SaurabhSinha-2006/MachXO4-Canvas/Doc/machx04_devboard.png

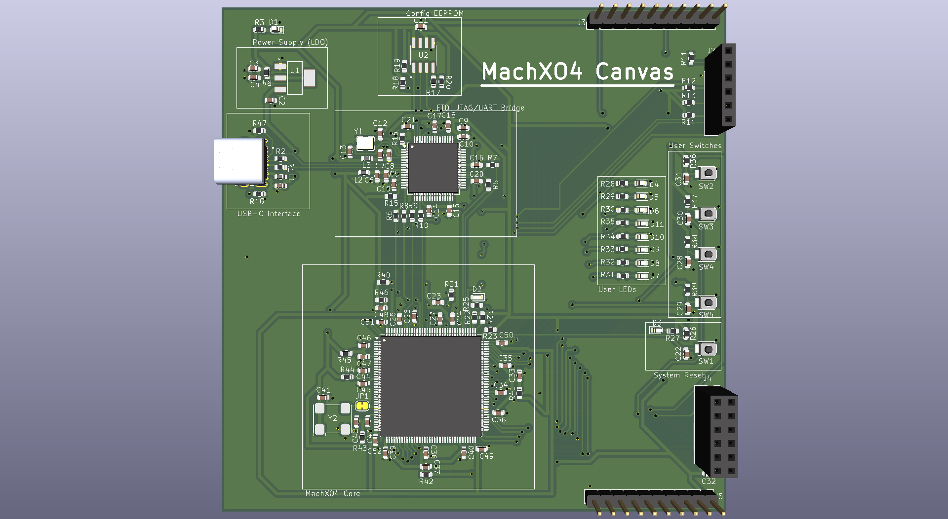
Doc/machx04_devboard.png
