SaurabhSinha-2006/MachXO4-Canvas/Hardware/Custom Library/93LC56C-I_SN/93LC56C-I_SN.step

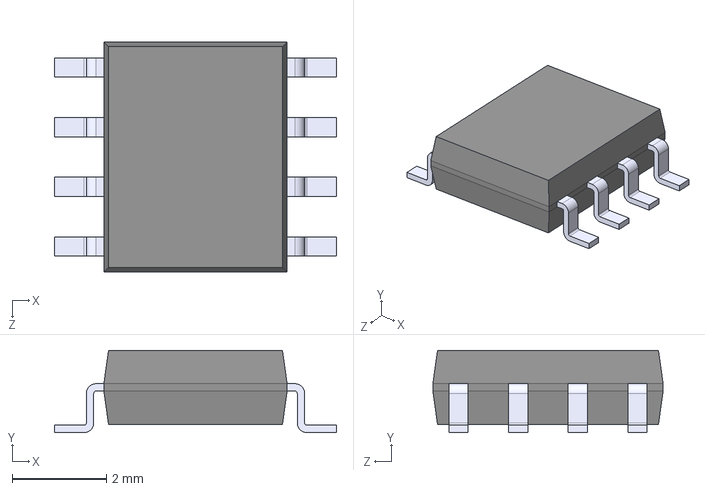
[picture p3: CAD file, 2026-10-26]
Hardware/Custom Library/93LC56C-I_SN/93LC56C-I_SN.step
6.00 x 1.75 x 4.90 mm
