SaurabhSinha-2006/MachXO4-Canvas/Hardware/Custom Library/FT2232HL-REEL/FT2232HL-REEL.step

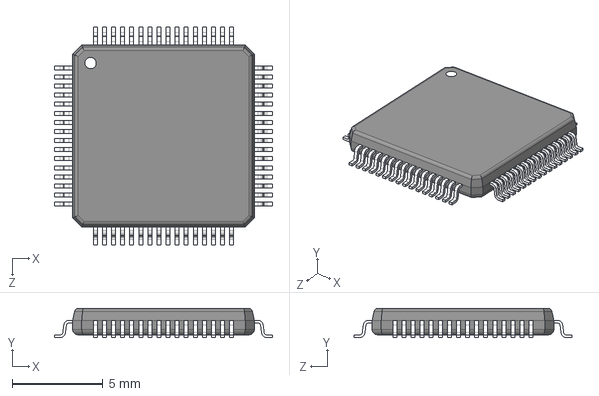
[picture p4: CAD file, 2026-10-26]
Hardware/Custom Library/FT2232HL-REEL/FT2232HL-REEL.step
12.0 x 1.60 x 12.0 mm
