SaurabhSinha-2006/MachXO4-Canvas/Hardware/Custom Library/NCP1117ST33T3G/NCP1117ST33T3G.step

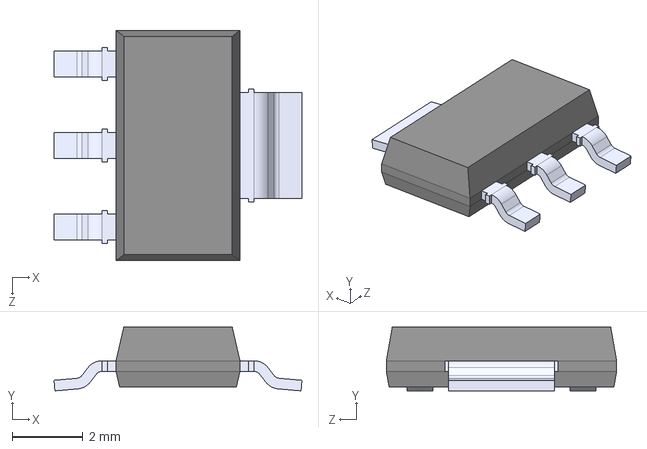
[picture p5: CAD file, 2026-10-26]
Hardware/Custom Library/NCP1117ST33T3G/NCP1117ST33T3G.step
7.00 x 1.80 x 6.50 mm
