SaurabhSinha-2006/MachXO4-Canvas/Hardware/Custom Library/USB4085-GF-A_REVA4/USB4085-GF-A_REVA4.step

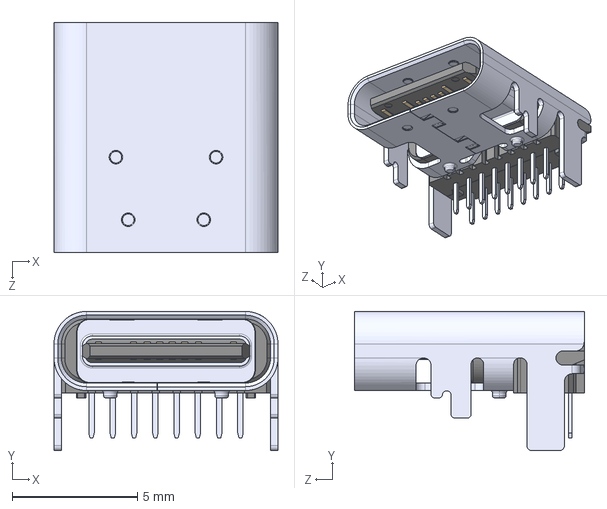
[picture p6: CAD file, 2026-10-26]
Hardware/Custom Library/USB4085-GF-A_REVA4/USB4085-GF-A_REVA4.step
8.95 x 5.56 x 9.17 mm
