SaurabhSinha-2006/MachXO4-Canvas/Hardware/Custom Library/61400416021/61400416021.step

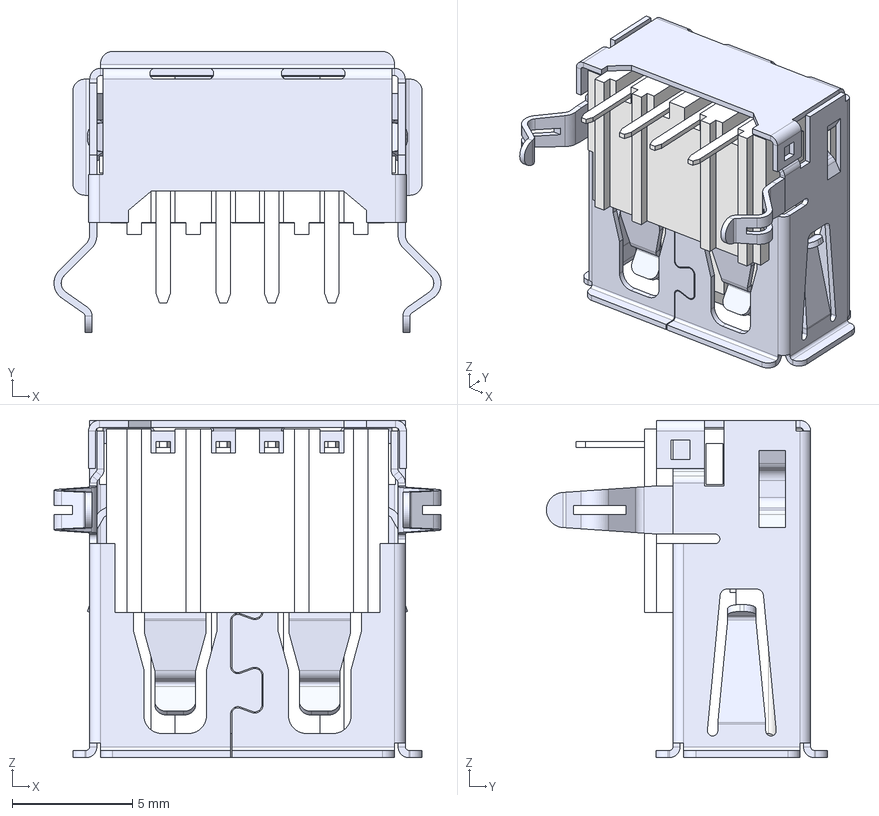
[picture p7: CAD file, 2026-10-26]
Hardware/Custom Library/61400416021/61400416021.step
16.1 x 11.7 x 14.0 mm
