SaurabhSinha-2006/MachXO4-Canvas/Doc/machx04_devboard.pdf

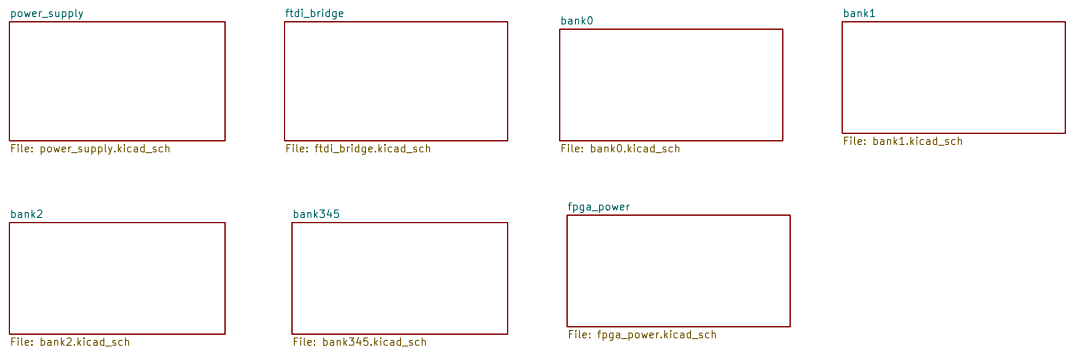
[picture p8: page 1]

Designed by: Saurabh Sinha
IIIT NR
Sheet: /
File: machx04_devboard.kicad_sch
Title: Master sheet

Size: A4 | Rev: v1.0
KiCad E.D.A. 10.0.5 | Id: 1/8

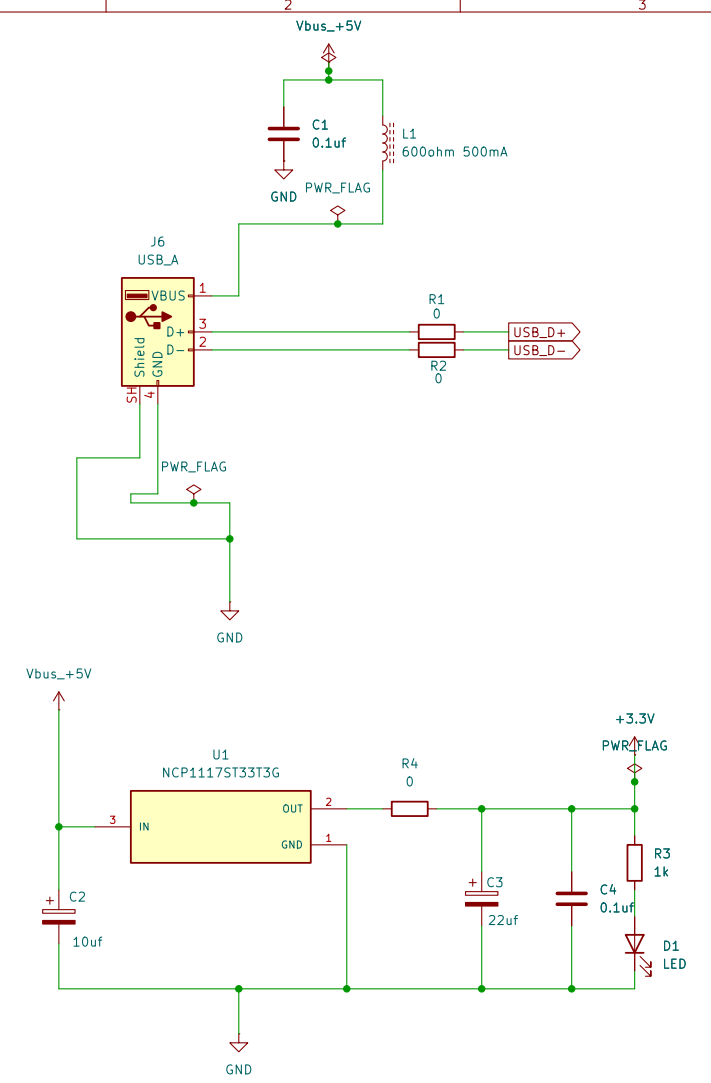
[picture p9: page 2]

Designed by: Saurabh Sinha
IIIT NR
Sheet: /power_supply/
File: power_supply.kicad_sch
Title: 3.3V Power Architecture

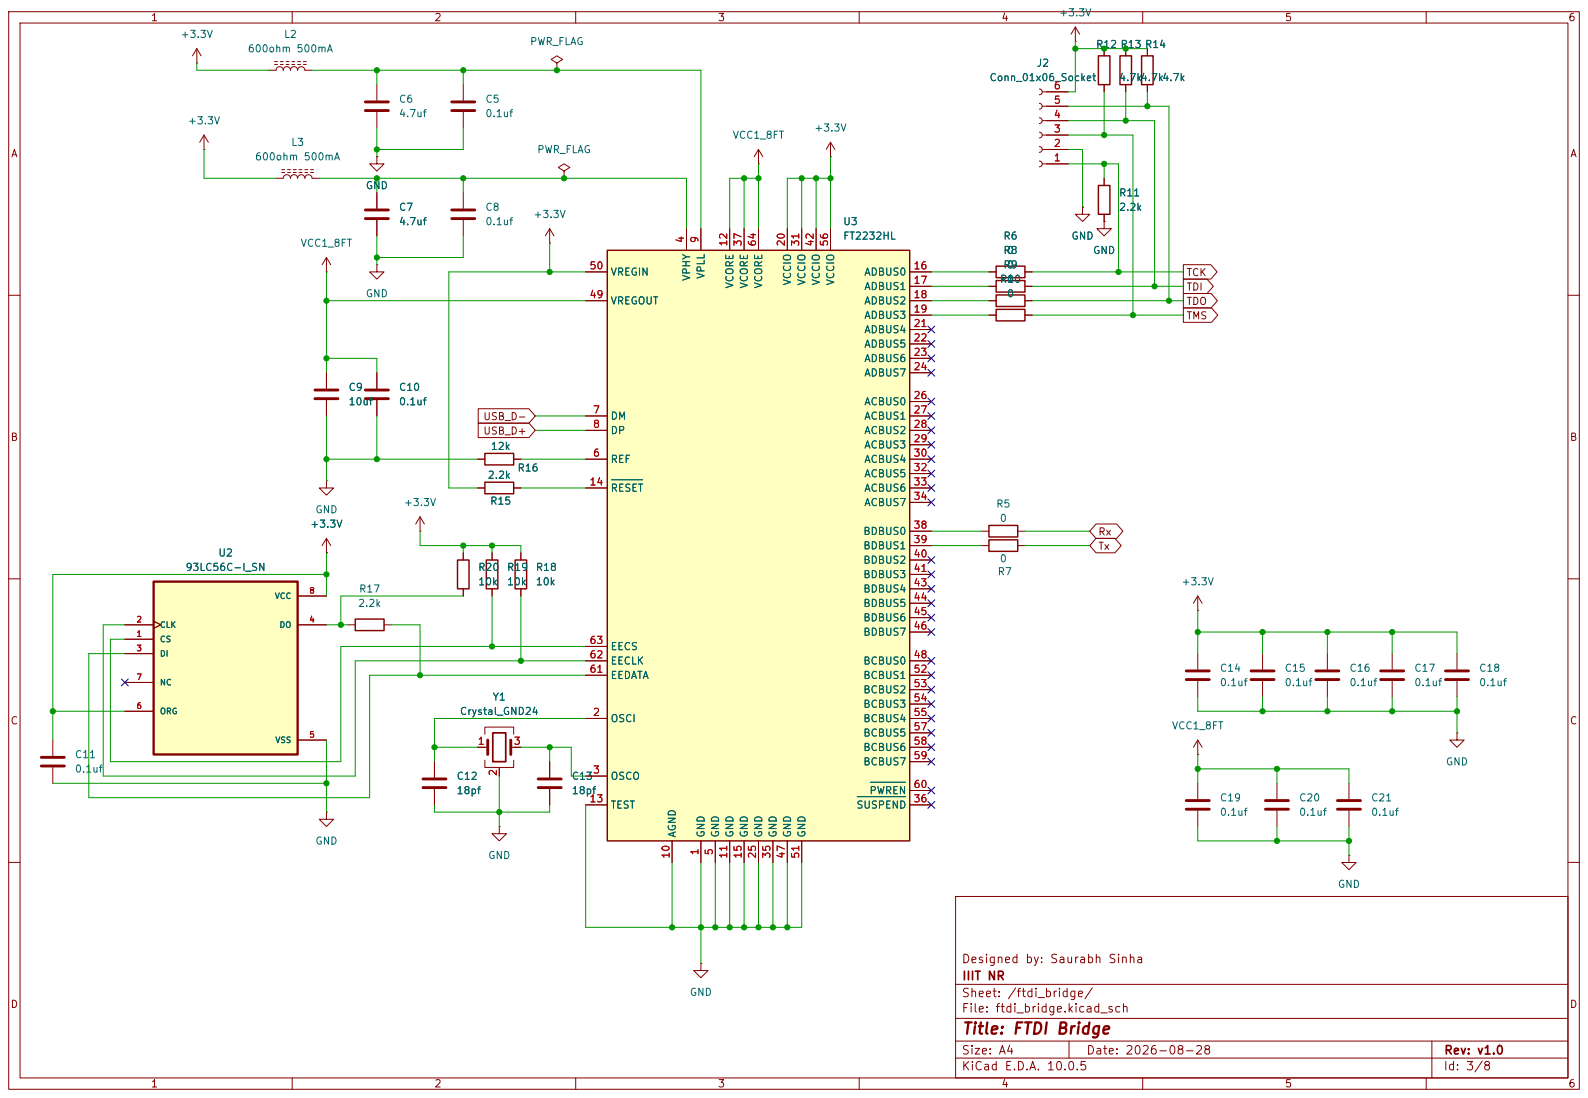
[picture p10: page 3]

5 REF 6 DM 7 DP 8 VPLL 9 AGND 10 GND 11 VCORE 12

1 OSCI 2 OSCO 3 VPHY 4 GND

Designed by: Saurabh Sinha
IIIT NR
Sheet: /ftdi_bridge/
File: ftdi_bridge.kicad_sch
Title: FTDI Bridge

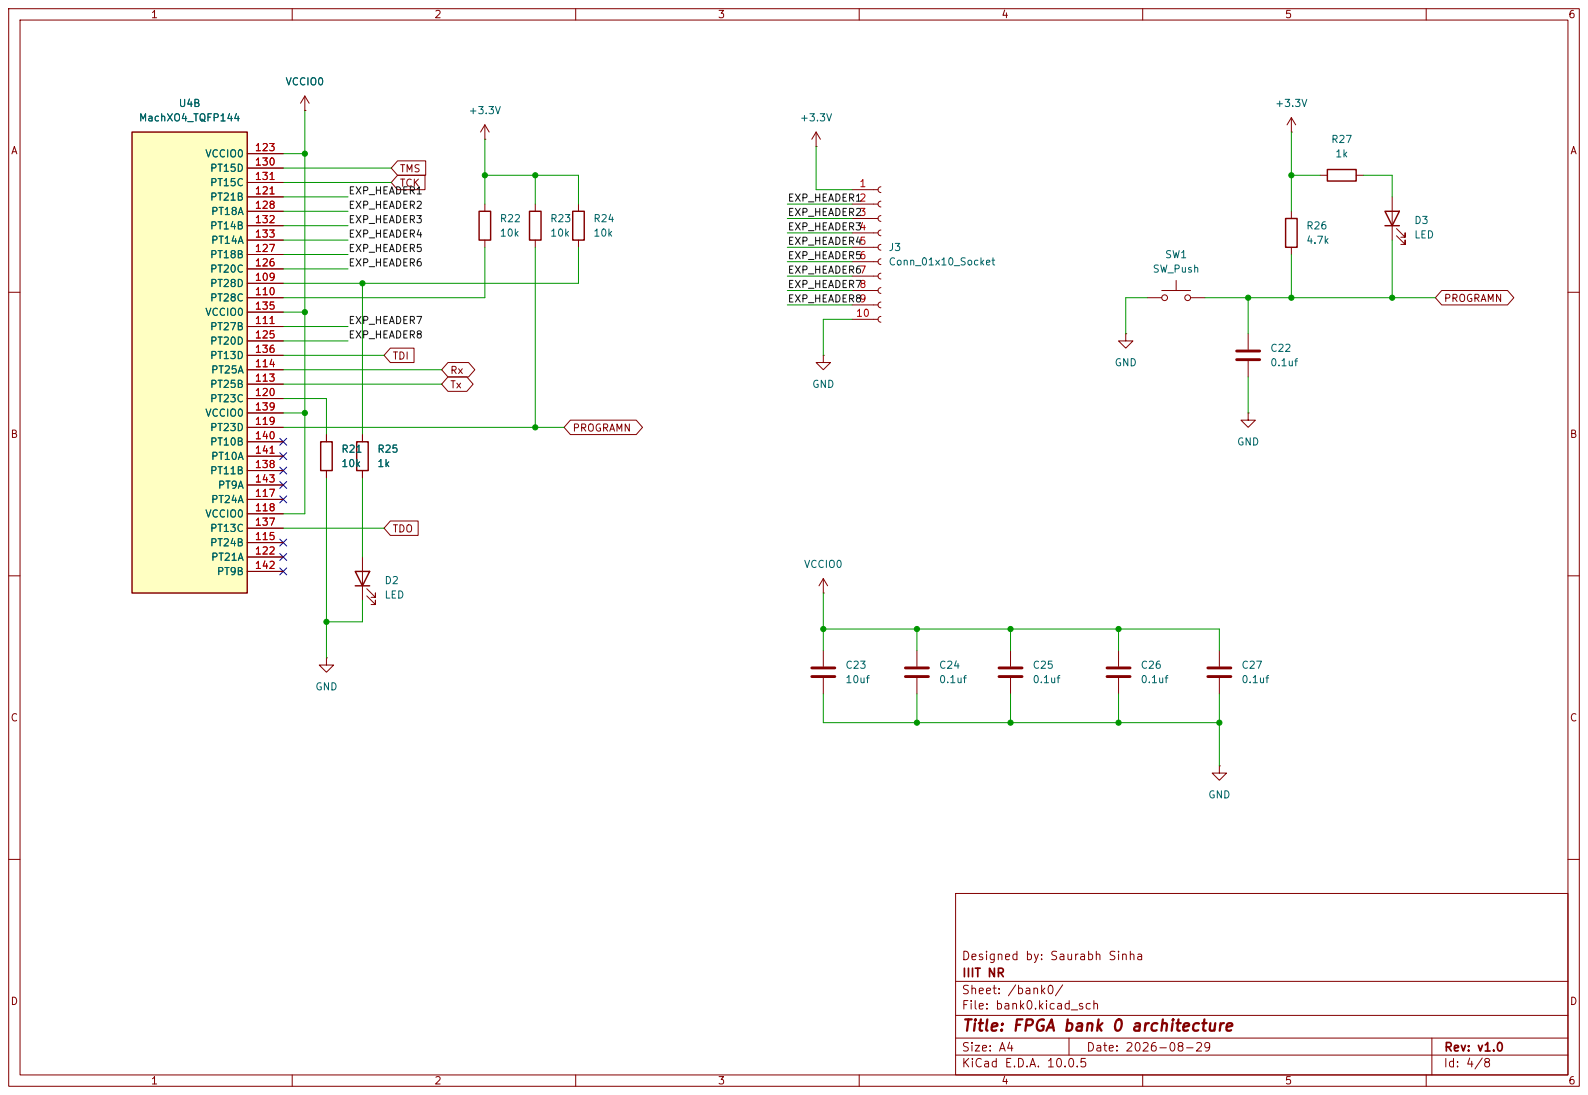
[picture p11: page 4]

Designed by: Saurabh Sinha
IIIT NR
Sheet: /bank0/
File: bank0.kicad_sch
Title: FPGA bank 0 architecture

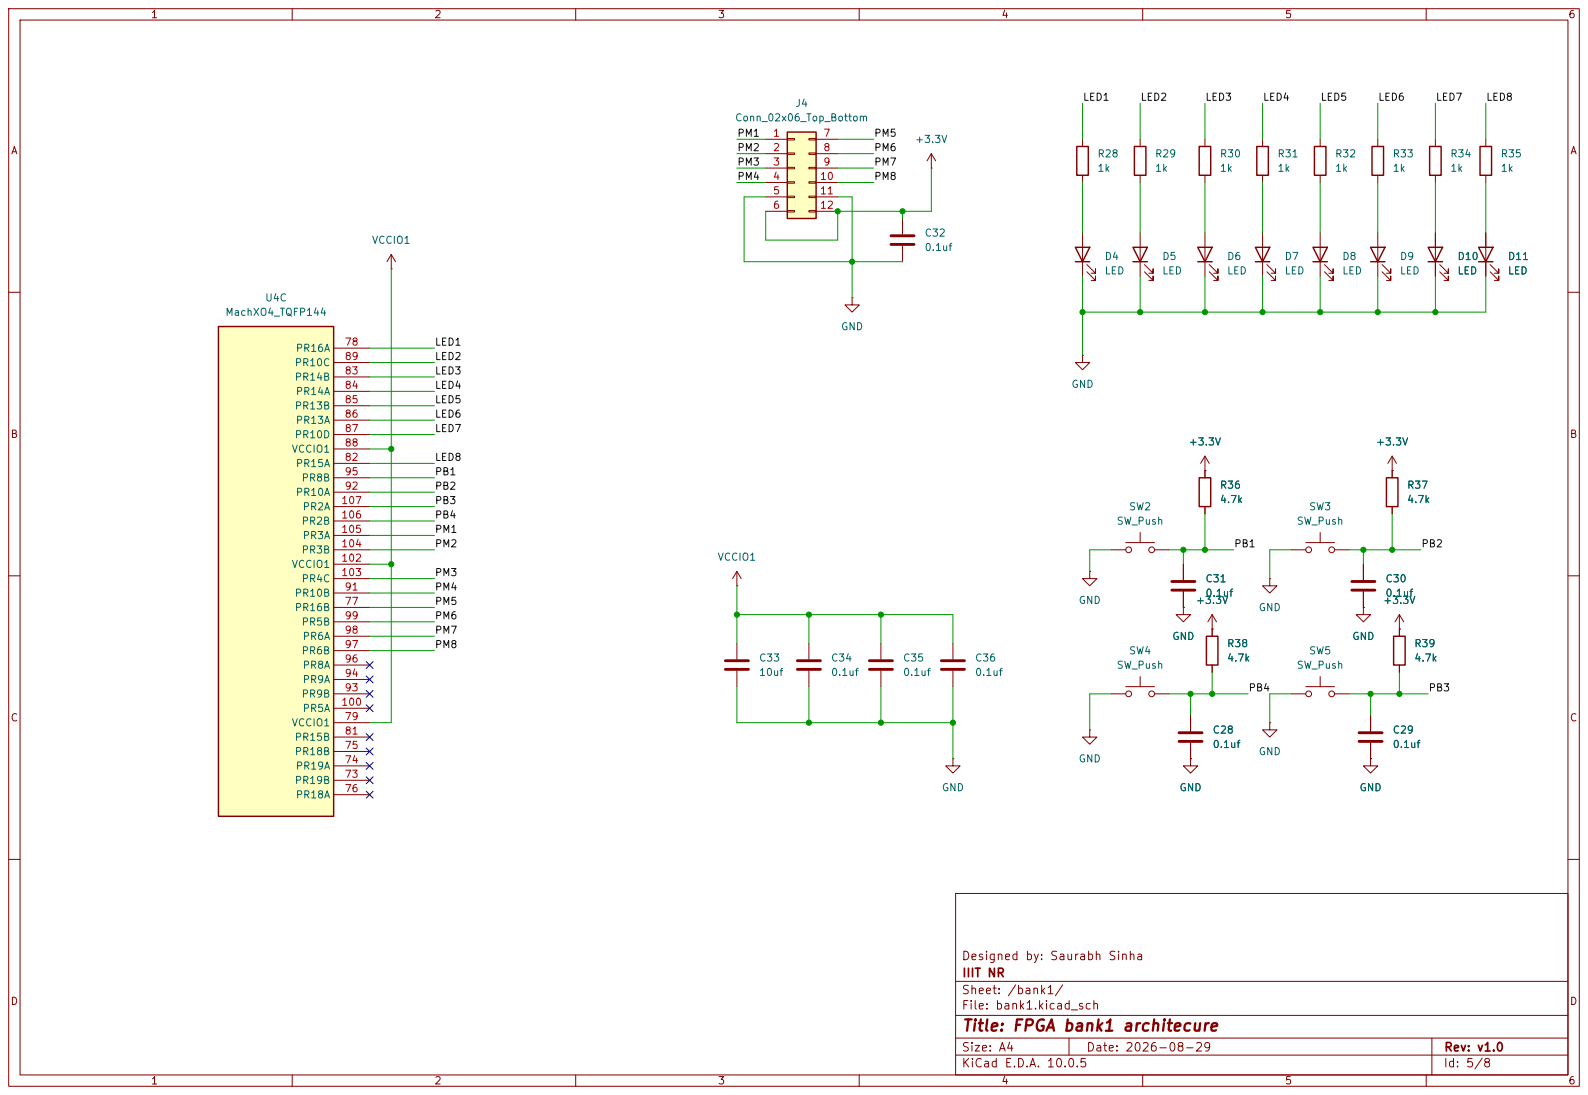
[picture p12: page 5]

Designed by: Saurabh Sinha
IIIT NR
Sheet: /bank1/
File: bank1.kicad_sch
Title: FPGA bank1 architecure

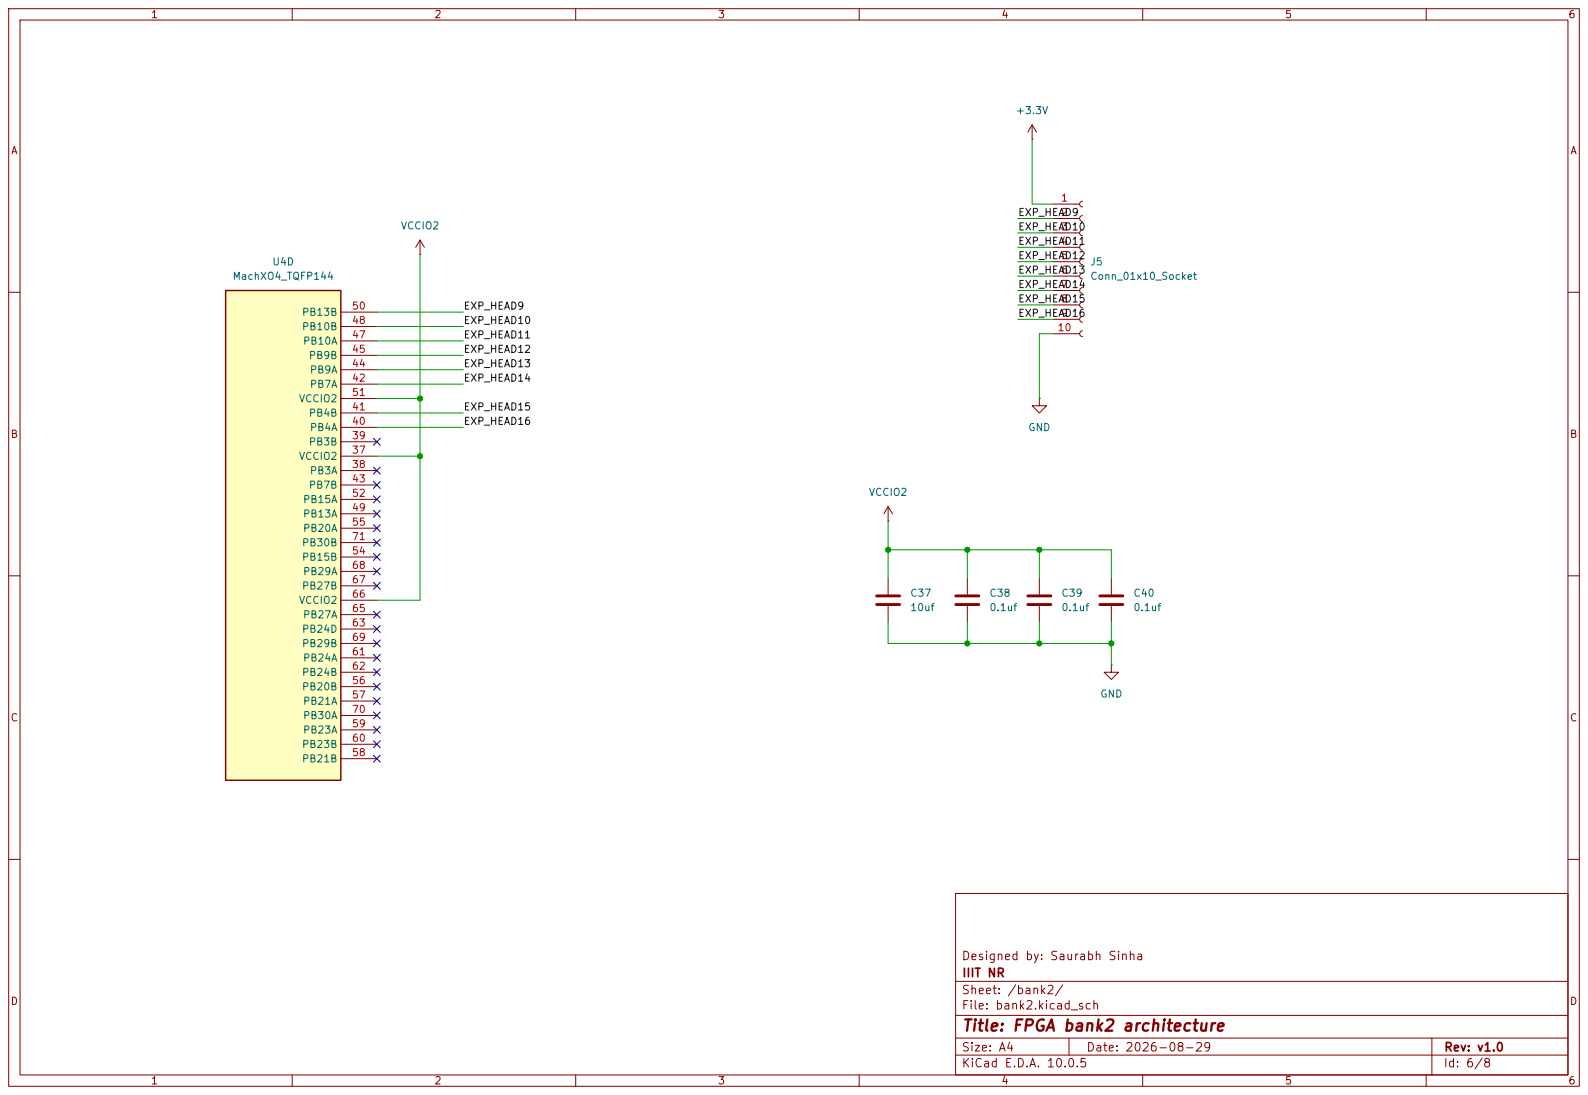
[picture p13: page 6]

Designed by: Saurabh Sinha
IIIT NR
Sheet: /bank2/
File: bank2.kicad_sch
Title: FPGA bank2 architecture

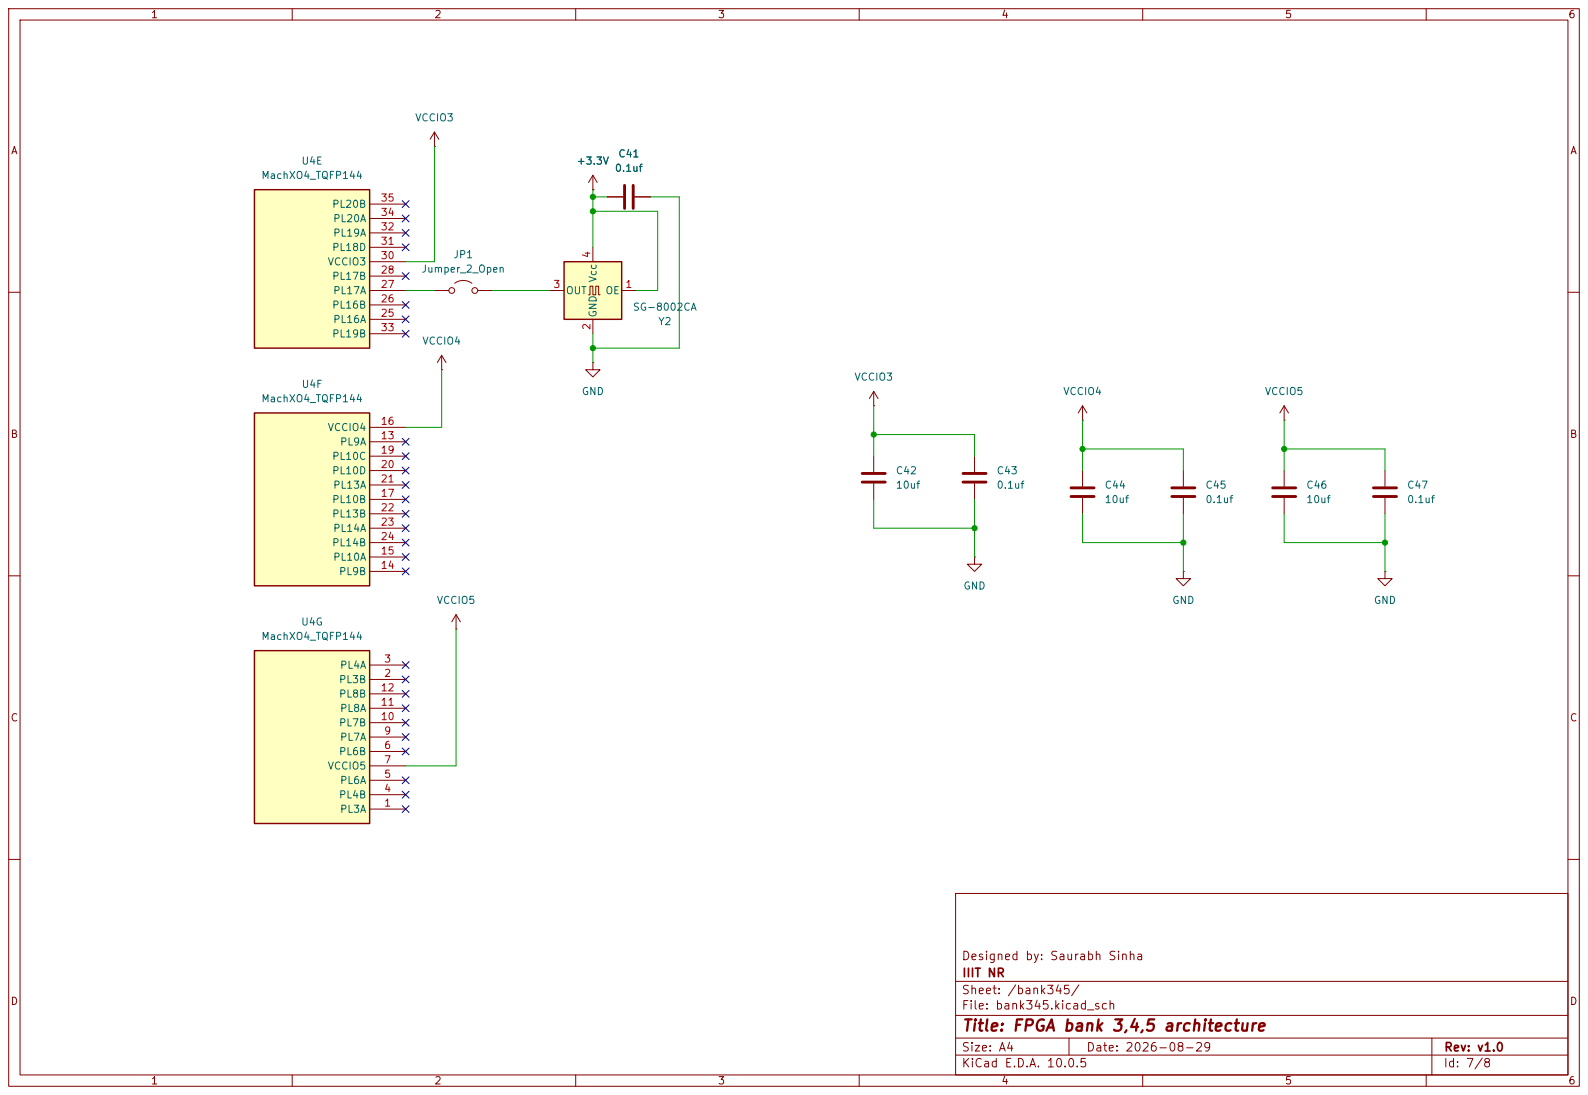
[picture p14: page 7]

Designed by: Saurabh Sinha
IIIT NR
Sheet: /bank345/
File: bank345.kicad_sch
Title: FPGA bank 3,4,5 architecture

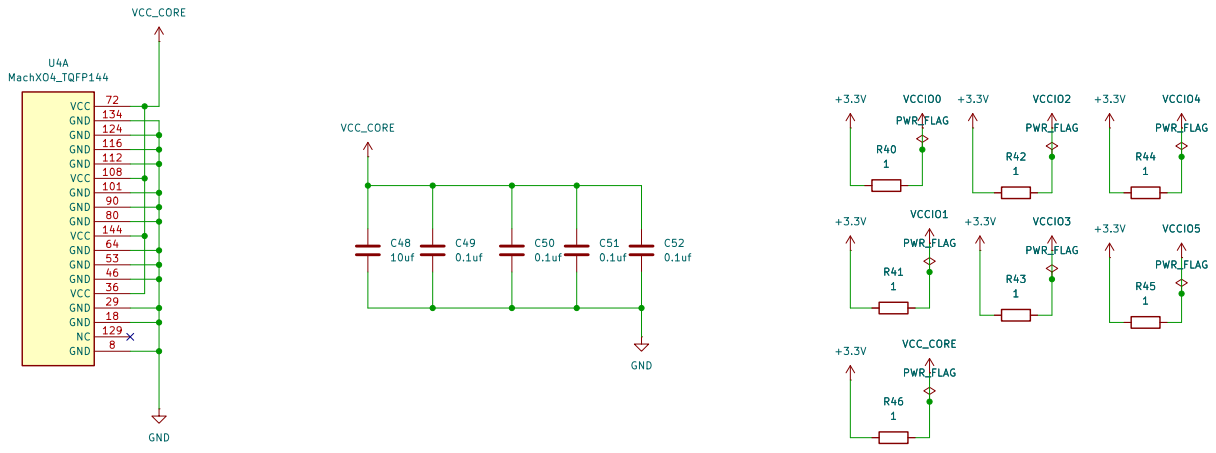
[picture p15: page 8]
