SaurabhSinha-2006/MachXO4-Canvas/Doc/layout_final.pdf

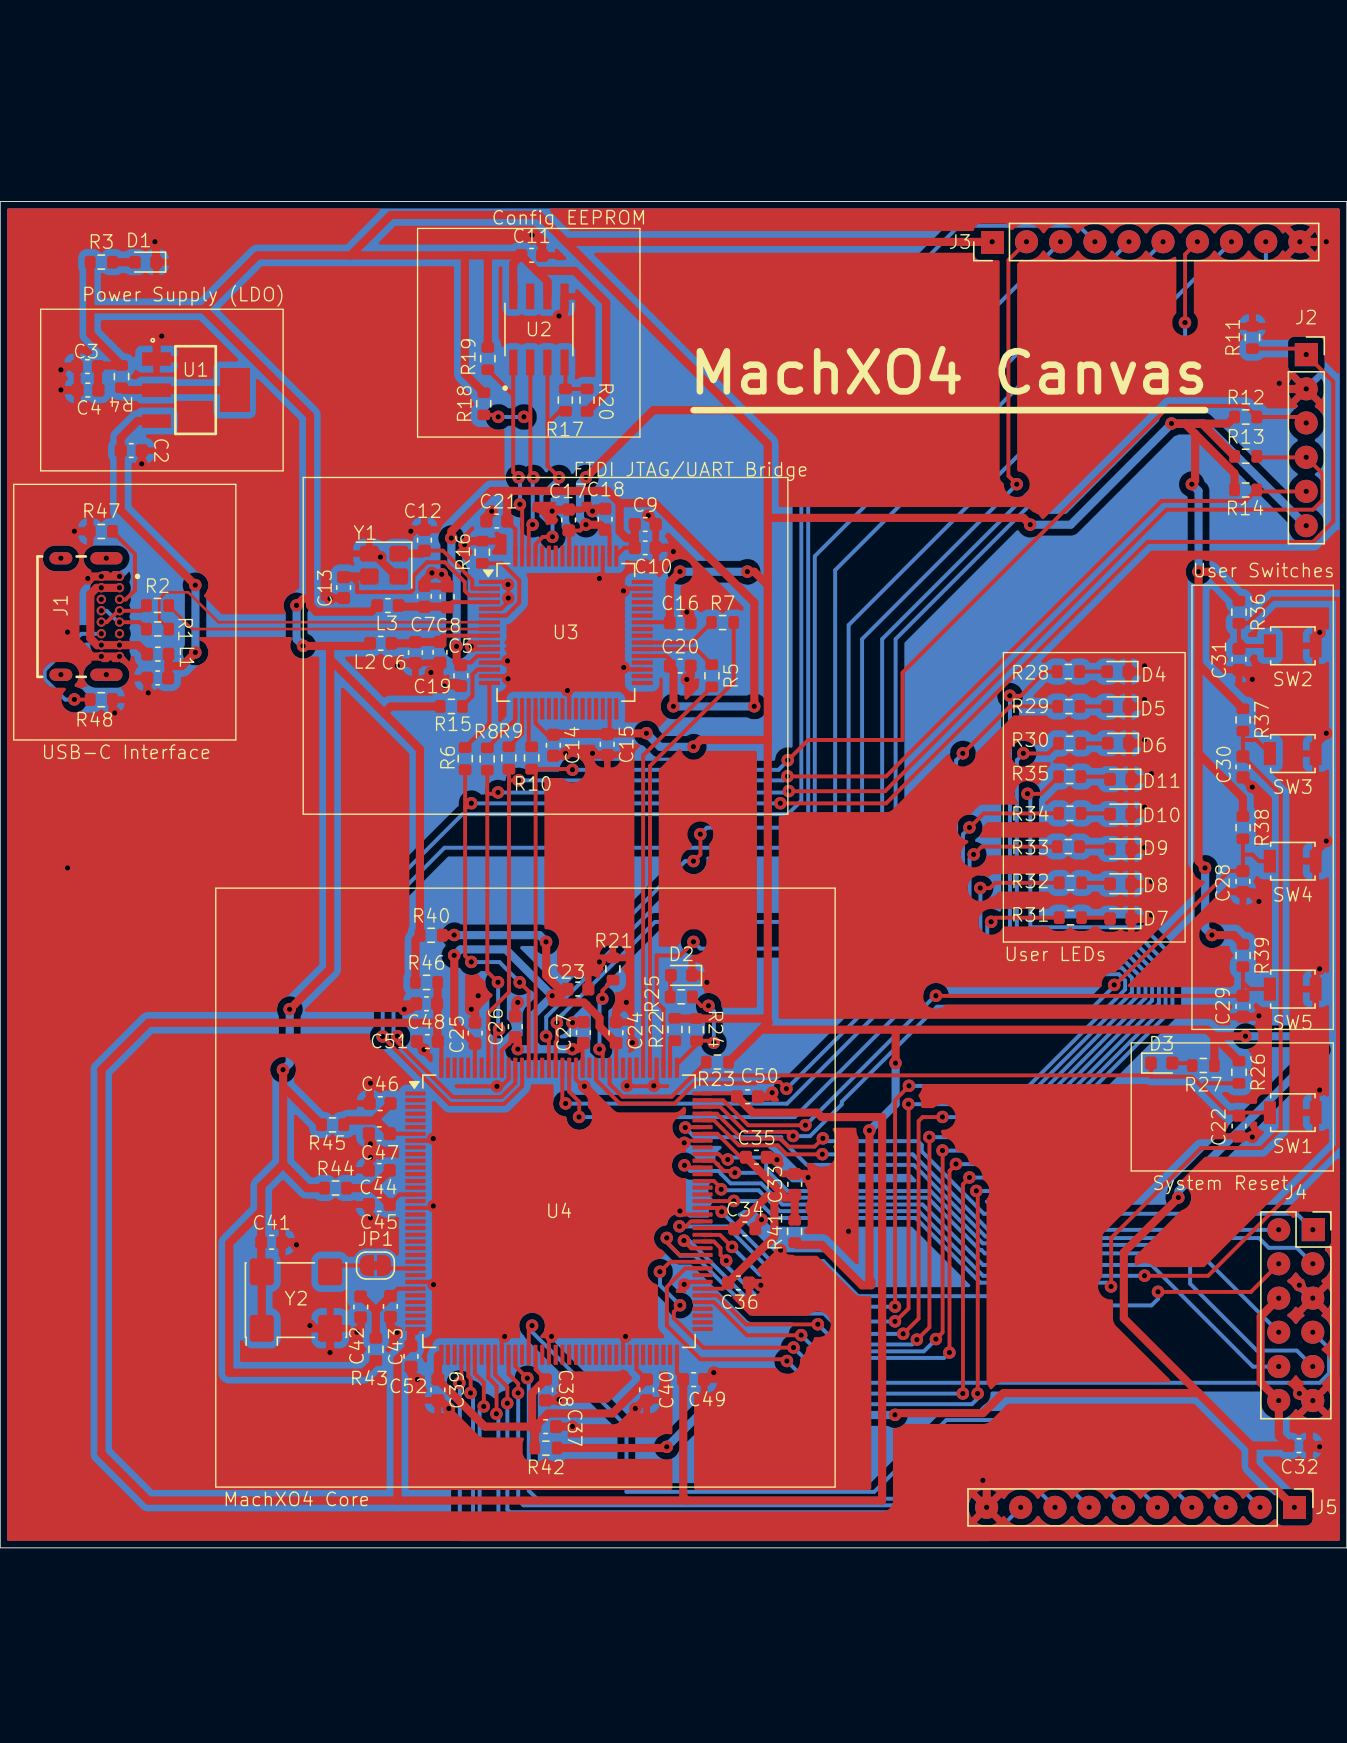
[picture p16: page 1]
