SaurabhSinha-2006/MachXO4-Canvas/Hardware/machx04_devboard.kicad_pcb

## KiCad design Hardware/machx04_devboard.kicad_pcb (2026-10-26)

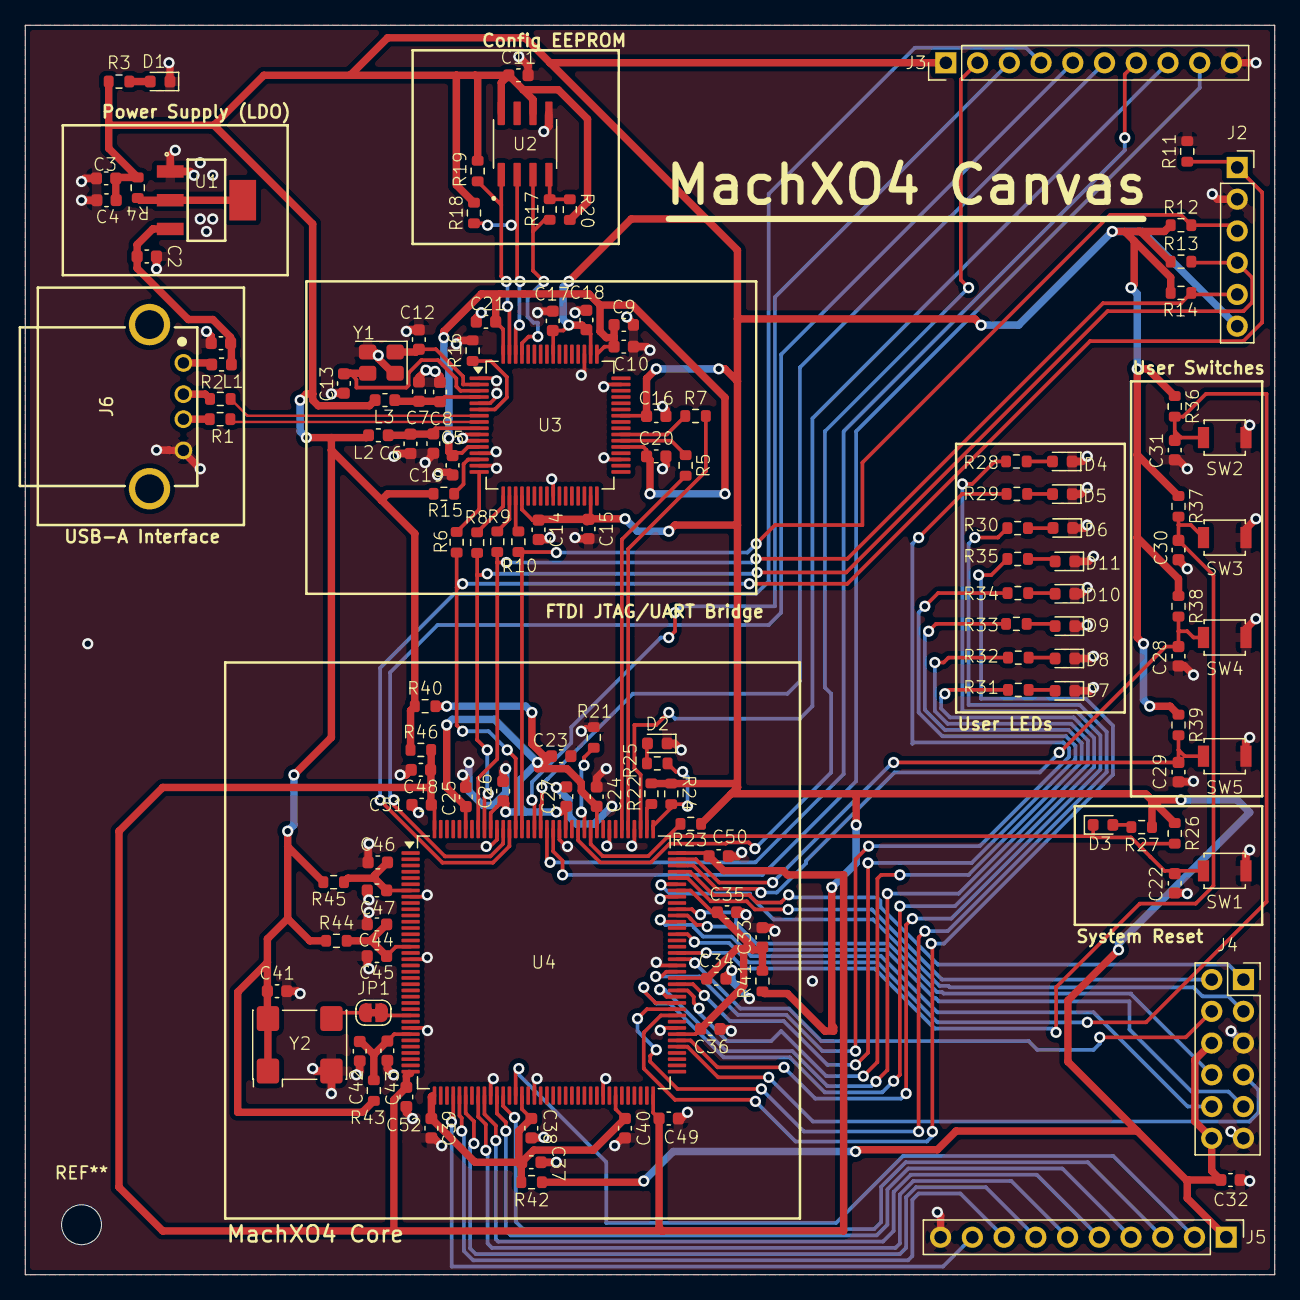
[picture p17: board machx04_devboard.kicad_pcb from above]

Board: 2 copper layers, 100.0 x 100.0 mm, 129 parts (0 on the bottom side), 92 nets.

Parts:
C1, C4, C5, C8, C10, C11, C14, C15, C16, C17, C18, C19, C20, C21, C22, C24, C25, C26, C27, C28, C29, C30, C31, C32, C34, C35, C36, C38, C39, C40, C41, C43, C45, C47, C49, C50, C51, C52: 0.1uf; C_0603_1608Metric
C2, C9, C23, C33, C37, C42, C44, C46, C48: 10uf; C_0603_1608Metric
C3: 22uf; C_0603_1608Metric
C6, C7: 4.7uf; C_0603_1608Metric
C12, C13: 18pf; C_0603_1608Metric
D1, D2, D3, D4, D5, D6, D7, D8, D9, D10, D11: LED; LED_0603_1608Metric
J2: Conn_01x06_Socket; PinSocket_1x06_P2.54mm_Vertical
J3, J5: Conn_01x10_Socket; PinHeader_1x10_P2.54mm_Vertical
J4: Conn_02x06_Top_Bottom; PinSocket_2x06_P2.54mm_Vertical
J6: USB_A; 61400416021
JP1: Jumper_2_Open; SolderJumper-2_P1.3mm_Bridged_RoundedPad1.0x1.5mm
L1, L2, L3: 600ohm 500mA; L_0603_1608Metric
R1, R2, R4, R5, R6, R7, R8, R9, R10: 0; R_0603_1608Metric
R3, R25, R27, R28, R29, R30, R31, R32, R33, R34, R35: 1k; R_0603_1608Metric
R11, R15, R17: 2.2k; R_0603_1608Metric
R12, R13, R14, R26, R36, R37, R38, R39: 4.7k; R_0603_1608Metric
R16: 12k; R_0603_1608Metric
R18, R19, R20, R21, R22, R23, R24: 10k; R_0603_1608Metric
R40, R41, R42, R43, R44, R45, R46: 1; R_0603_1608Metric
SW1, SW2, SW3, SW4, SW5: SW_Push; SW_SPST_B3U-1000P
U1: NCP1117ST33T3G; SOT230P700X180-4N
U2: 93LC56C-I_SN; SOIC127P600X175-8N
U3: FT2232HL; LQFP-64_10x10mm_P0.5mm
U4: MachXO4_TQFP144; TQFP-144_20x20mm_P0.5mm
Y1: Crystal_GND24; Crystal_SMD_3225-4Pin_3.2x2.5mm
Y2: SG-8002CA; Oscillator_SMD_SeikoEpson_SG8002CA-4Pin_7.0x5.0mm

Connections:
+3.3V: C3.1, C4.1, C11.1, C14.1, C15.1, C16.1, C17.1, C18.1, C32.1, C41.1, J2.6, J3.1, J4.6, J4.12, J5.1, L2.1, L3.1, R3.1, R4.2, R12.1, R13.1, R14.1, R15.1, R18.1, R19.1, R20.1, R22.1, R23.1, R24.1, R26.1, R27.1, R36.1, R37.1, R38.1, R39.1, R40.1, R41.1, R42.1, R43.1, R44.1, R45.1, R46.1, U2.6 (ORG), U2.8 (VCC), U3.20 (VCCIO), U3.31 (VCCIO), U3.42 (VCCIO), U3.50 (VREGIN), U3.56 (VCCIO), Y2.1 (OE), Y2.4 (Vcc)
/bank0/EXP_HEADER1: J3.2, U4.121 (PT21B)
/bank0/EXP_HEADER2: J3.3, U4.128 (PT18A)
/bank0/EXP_HEADER3: J3.4, U4.132 (PT14B)
/bank0/EXP_HEADER4: J3.5, U4.133 (PT14A)
/bank0/EXP_HEADER5: J3.6, U4.127 (PT18B)
/bank0/EXP_HEADER6: J3.7, U4.126 (PT20C)
/bank0/EXP_HEADER7: J3.8, U4.111 (PT27B)
/bank0/EXP_HEADER8: J3.9, U4.125 (PT20D)
/bank1/LED1: R28.1, U4.78 (PR16A)
/bank1/LED2: R29.1, U4.89 (PR10C)
/bank1/LED3: R30.1, U4.83 (PR14B)
/bank1/LED4: R31.1, U4.84 (PR14A)
/bank1/LED5: R32.1, U4.85 (PR13B)
/bank1/LED6: R33.1, U4.86 (PR13A)
/bank1/LED7: R34.1, U4.87 (PR10D)
/bank1/LED8: R35.1, U4.82 (PR15A)
/bank1/PB1: C31.1, R36.2, SW2.2, U4.95 (PR8B)
/bank1/PB2: C30.1, R37.2, SW3.2, U4.92 (PR10A)
/bank1/PB3: C29.1, R39.2, SW5.2, U4.107 (PR2A)
/bank1/PB4: C28.1, R38.2, SW4.2, U4.106 (PR2B)
/bank1/PM1: J4.1, U4.105 (PR3A)
/bank1/PM2: J4.2, U4.104 (PR3B)
/bank1/PM3: J4.3, U4.103 (PR4C)
/bank1/PM4: J4.4, U4.91 (PR10B)
/bank1/PM5: J4.7, U4.77 (PR16B)
/bank1/PM6: J4.8, U4.99 (PR5B)
/bank1/PM7: J4.9, U4.98 (PR6A)
/bank1/PM8: J4.10, U4.97 (PR6B)
/bank2/EXP_HEAD9: J5.2, U4.50 (PB13B)
/bank2/EXP_HEAD10: J5.3, U4.48 (PB10B)
/bank2/EXP_HEAD11: J5.4, U4.47 (PB10A)
/bank2/EXP_HEAD12: J5.5, U4.45 (PB9B)
/bank2/EXP_HEAD13: J5.6, U4.44 (PB9A)
/bank2/EXP_HEAD14: J5.7, U4.42 (PB7A)
/bank2/EXP_HEAD15: J5.8, U4.41 (PB4B)
/bank2/EXP_HEAD16: J5.9, U4.40 (PB4A)
GND: C1.2, C2.2, C3.2, C4.2, C5.2, C6.2, C7.2, C8.2, C9.2, C10.2, C11.2, C12.2, C13.2, C14.2, C15.2, C16.2, C17.2, C18.2, C19.2, C20.2, C21.2, C22.2, C23.2, C24.2, C25.2, C26.2, C27.2, C28.2, C29.2, C30.2, C31.2, C32.2, C33.2, C34.2, C35.2, C36.2, C37.2, C38.2, C39.2, C40.2, C41.2, C42.1, C43.1, C44.1, C45.1, C46.1, C47.1, C48.2, C49.2, C50.2, C51.2, C52.2, D1.1 (K), D2.1 (K), D4.1 (K), D5.1 (K), D6.1 (K), D7.1 (K), D8.1 (K), D9.1 (K), D10.1 (K), D11.1 (K), J2.2, J3.10, J4.5, J4.11, J5.10, J6.4 (GND), R11.2, R16.1, R21.2, SW1.1, SW2.1, SW3.1, SW4.1, SW5.1, U1.1 (GND), U2.5 (VSS), U3.1 (GND), U3.5 (GND), U3.10 (AGND), U3.11 (GND), U3.13 (TEST), U3.15 (GND), U3.25 (GND), U3.35 (GND), U3.47 (GND), U3.51 (GND), U4.8 (GND), U4.18 (GND), U4.29 (GND), U4.46 (GND), U4.53 (GND), U4.64 (GND), U4.80 (GND), U4.90 (GND), U4.101 (GND), U4.112 (GND), U4.116 (GND), U4.124 (GND), U4.134 (GND), Y1.2 (G), Y1.4 (G), Y2.2 (GND)
unnamed: D1.2 (A), R3.2
unnamed: D2.2 (A), R25.2
unnamed: D3.2 (A), R27.2
unnamed: D4.2 (A), R28.2
unnamed: D5.2 (A), R29.2
unnamed: D6.2 (A), R30.2
unnamed: D7.2 (A), R31.2
unnamed: D8.2 (A), R32.2
unnamed: D9.2 (A), R33.2
unnamed: D10.2 (A), R34.2
unnamed: D11.2 (A), R35.2
unnamed: J6.3 (D+), R1.1
unnamed: J6.2 (D-), R2.1
unnamed: J6.1 (VBUS), L1.2
unnamed: JP1.1 (A), U4.27 (PL17A)
unnamed: JP1.2 (B), Y2.3 (OUT)
unnamed: R4.1, U1.2 (OUT), U1.4 (OUT)
unnamed: R18.2, U2.2 (CLK), U3.62 (EECLK)
unnamed: R19.2, U2.1 (CS), U3.63 (EECS)
unnamed: R17.2, U2.3 (DI), U3.61 (EEDATA)
unnamed: R17.1, R20.2, U2.4 (DO)
unnamed: R6.1, U3.16 (ADBUS0)
unnamed: R8.1, U3.17 (ADBUS1)
unnamed: R9.1, U3.18 (ADBUS2)
unnamed: R10.1, U3.19 (ADBUS3)
unnamed: R5.1, U3.38 (BDBUS0)
unnamed: R7.1, U3.39 (BDBUS1)
unnamed: C12.1, U3.2 (OSCI), Y1.1
unnamed: C13.1, U3.3 (OSCO), Y1.3
unnamed: R16.2, U3.6 (REF)
unnamed: C7.1, C8.1, L3.2, U3.4 (VPHY)
unnamed: C5.1, C6.1, L2.2, U3.9 (VPLL)
unnamed: R15.2, U3.14 (~RESET)
unnamed: R21.1, U4.120 (PT23C)
unnamed: R22.2, U4.110 (PT28C)
unnamed: R24.2, R25.1, U4.109 (PT28D)
PROGRAMN: C22.1, D3.1 (K), R23.2, R26.2, SW1.2, U4.119 (PT23D)
Rx: R5.2, U4.114 (PT25A)
TCK: J2.1, R6.2, R11.1, U4.131 (PT15C)
TDI: J2.4, R8.2, R13.2, U4.136 (PT13D)
TDO: J2.5, R9.2, R14.2, U4.137 (PT13C)
TMS: J2.3, R10.2, R12.2, U4.130 (PT15D)
Tx: R7.2, U4.113 (PT25B)
USB_D+: R1.2, U3.8 (DP)
USB_D-: R2.2, U3.7 (DM)
VCC1_8FT: C9.1, C10.1, C19.1, C20.1, C21.1, U3.12 (VCORE), U3.37 (VCORE), U3.49 (VREGOUT), U3.64 (VCORE)
VCCIO0: C23.1, C24.1, C25.1, C26.1, C27.1, R40.2, U4.118 (VCCIO0), U4.123 (VCCIO0), U4.135 (VCCIO0), U4.139 (VCCIO0)
VCCIO1: C33.1, C34.1, C35.1, C36.1, R41.2, U4.79 (VCCIO1), U4.88 (VCCIO1), U4.102 (VCCIO1)
VCCIO2: C37.1, C38.1, C39.1, C40.1, R42.2, U4.37 (VCCIO2), U4.51 (VCCIO2), U4.66 (VCCIO2)
VCCIO3: C42.2, C43.2, R43.2, U4.30 (VCCIO3)
VCCIO4: C44.2, C45.2, R44.2, U4.16 (VCCIO4)
VCCIO5: C46.2, C47.2, R45.2, U4.7 (VCCIO5)
VCC_CORE: C48.1, C49.1, C50.1, C51.1, C52.1, R46.2, U4.36 (VCC), U4.72 (VCC), U4.108 (VCC), U4.144 (VCC)
Vbus_+5V: C1.1, C2.1, L1.1, U1.3 (IN)
