SaurabhSinha-2006/MachXO4-Canvas/(commit log)

2026-10-26 Initial commit: Final 2-layer PCB layout and manufacturing files
    [61400416021.step, 93LC56C-I_SN.step, FT2232HL-REEL.step, NCP1117ST33T3G.step, USB4085-GF-A_REVA4.step, machx04_devboard.kicad_pcb, machx04_devboard.kicad_sch]
2026-10-26 Enhance README with detailed board information
    Expanded the README to provide detailed information about the MachXO4-Canvas board, including its specifications, repository structure, and fabrication instructions.
